hardwaredreams/HD-AK4316/documents/I2C-ADDR-TRANS-1.png

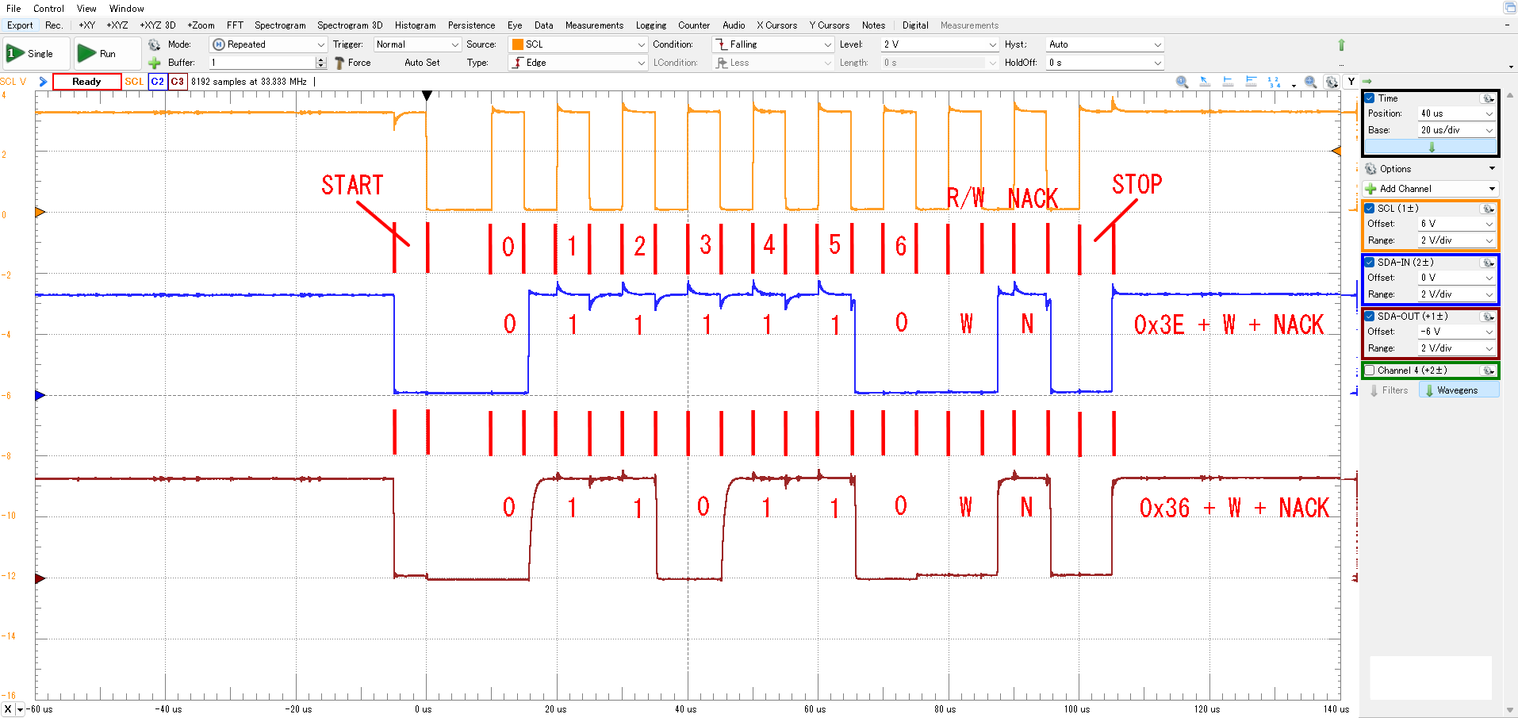
documents/I2C-ADDR-TRANS-1.png
