hardwaredreams/HD-AK4316/documents/I2C-ADDR-TRANS-1s.png

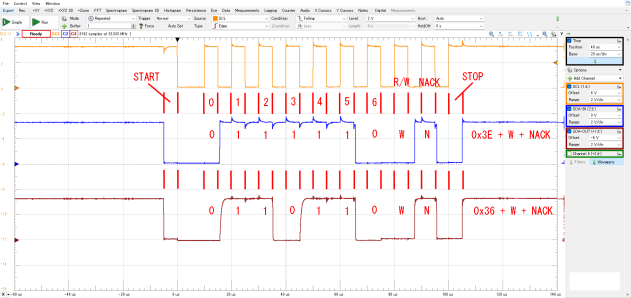
documents/I2C-ADDR-TRANS-1s.png
