hardwaredreams/HD-AK4316/documents/i2c-bus1.png

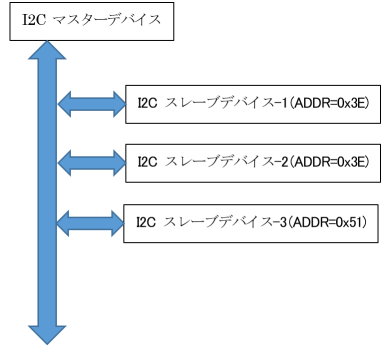
documents/i2c-bus1.png
