hardwaredreams/HD-AK4316/documents/i2c-bus2.png

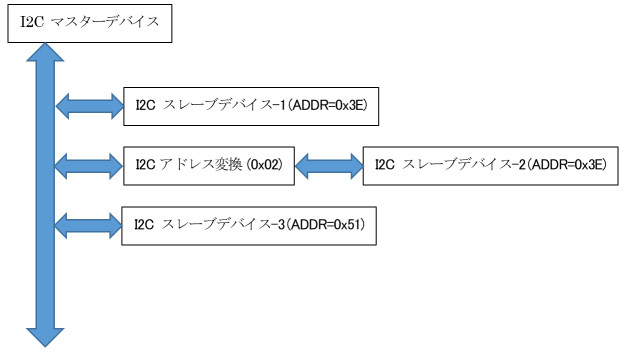
documents/i2c-bus2.png
