hardwaredreams/HD-AK4316/documents/bomlist.xlsx

 |  |  |  |  |  |  | SMT版 完成品 |  | 基板のみ
No. | リファレンス | 数量 | SMT版 | リード版 | 品名 | 仕様 | SMT版 型番 (参考) | メーカー | リード版 型番 (参考) | メーカー | 販売店 (参考) | 秋月電子販売コード | 備考
1 | C1 | 1 | 1 | 0 | セラミックコンデンサ | 1uF/10V以上 | CL10A105KA8NNNC | Samsung Electro-Mechanics |  |  | 秋月電子、Digikey ほか |  | 相当品可
2 | C2 | 1 | 1 | 0 | セラミックコンデンサ | 470pF/10V以上 | C0603C471J5GAC7867 | KEMET |  |  | 秋月電子、Digikey ほか |  | 相当品可
3 | C3 | 1 | 1 | 0 | セラミックコンデンサ | 2.2uF/10V以上 | GRM188R61E225KA12J | Murata Electronics |  |  | 秋月電子、Digikey ほか |  | 相当品可
4 | C4 | 1 | 0 | 1 | セラミックコンデンサ | 1uF/10V以上 |  |  | RDER71H105K2K1H03B | 株式会社村田製作所 | 秋月電子、Digikey ほか | 108150 | 相当品可
5 | C5 | 1 | 0 | 1 | セラミックコンデンサ | 2.2uF/10V以上 |  |  | RDER71H225K2K1H03B | 株式会社村田製作所 | 秋月電子、Digikey ほか | 108152 | 相当品可
6 | CN1, CN2 | 2 | 2 | 2 | Grove コネクタ(互換品) | HY-2 | 114020162/114020164 | Seeed Studio(シードスタジオ) | 114020162/114020164 | Seeed Studio(シードスタジオ) | 秋月電子、スイッチサイエンスほか | 115514 | 相当品可
7 | R1, R2, R3 | 3 | 3 | 2 | 抵抗 | 10k/0.25W | RC0603FR-0710KL | YAGEO | RD25S 10K | SHIH HAO Electronics CO.,LTD | 秋月電子 ほか | 125103 | 相当品可
8 | R4 | 1 | 0 | 0 | 抵抗 | OPEN (未実装) |  |  |  |  |  |  | 設定値により変更 1%級以上 相当品可
9 | R5 | 1 | 1 | 1 | 抵抗 | 0 (ジャンパ抵抗) | ERJ-3GEY0R00V | Panasonic | RD25S 0E | SHIH HAO Electronics CO.,LTD | 秋月電子 ほか | 125000 | 設定値により変更 1%級以上 相当品可
10 | R6 | 1 | 1 | 1 | 抵抗 | 887k/1%/0.25W | ERJ-3EKF8873V | Panasonic | MFR-25FTE52-887K | YAGEO | Digikey, マルツ ほか |  | 設定値により変更 1%級以上 相当品可
11 | R7 | 1 | 1 | 1 | 抵抗 | 1000k/1%/0.25W | ERJ-3EKF1004V | Panasonic | MFR-25FTE52-1M | YAGEO | Digikey, マルツ ほか |  | 設定値により変更 1%級以上 相当品可
12 | U1 | 1 | 1 | 1 | I2Cアドレス変換基板 | AE-LTC4316 | AE-LTC4316 | 秋月電子 | AE-LTC4316 | 秋月電子 | 秋月電子 | 115789
13 | U2 | 1 | 1 | 0 | LDO 電源IC | TPS74033FS5 | TPS74033SF5 | TAEJIN TECHNOLOGY |  |  | 秋月電子 | 117230 | 相当品可 (パッケージ等に注意)
14 | U3 | 1 | 0 | 1 | LDO 電源IC | LP2950L-33-T92-K |  |  | LP2950L-33-T92-K | UNISONIC TECHNOLOGIES | 秋月電子 | 108749 | 相当品可 (パッケージ等に注意)
