hardwaredreams/HD-AK4316/documents/HD-AK4316_schematic.pdf

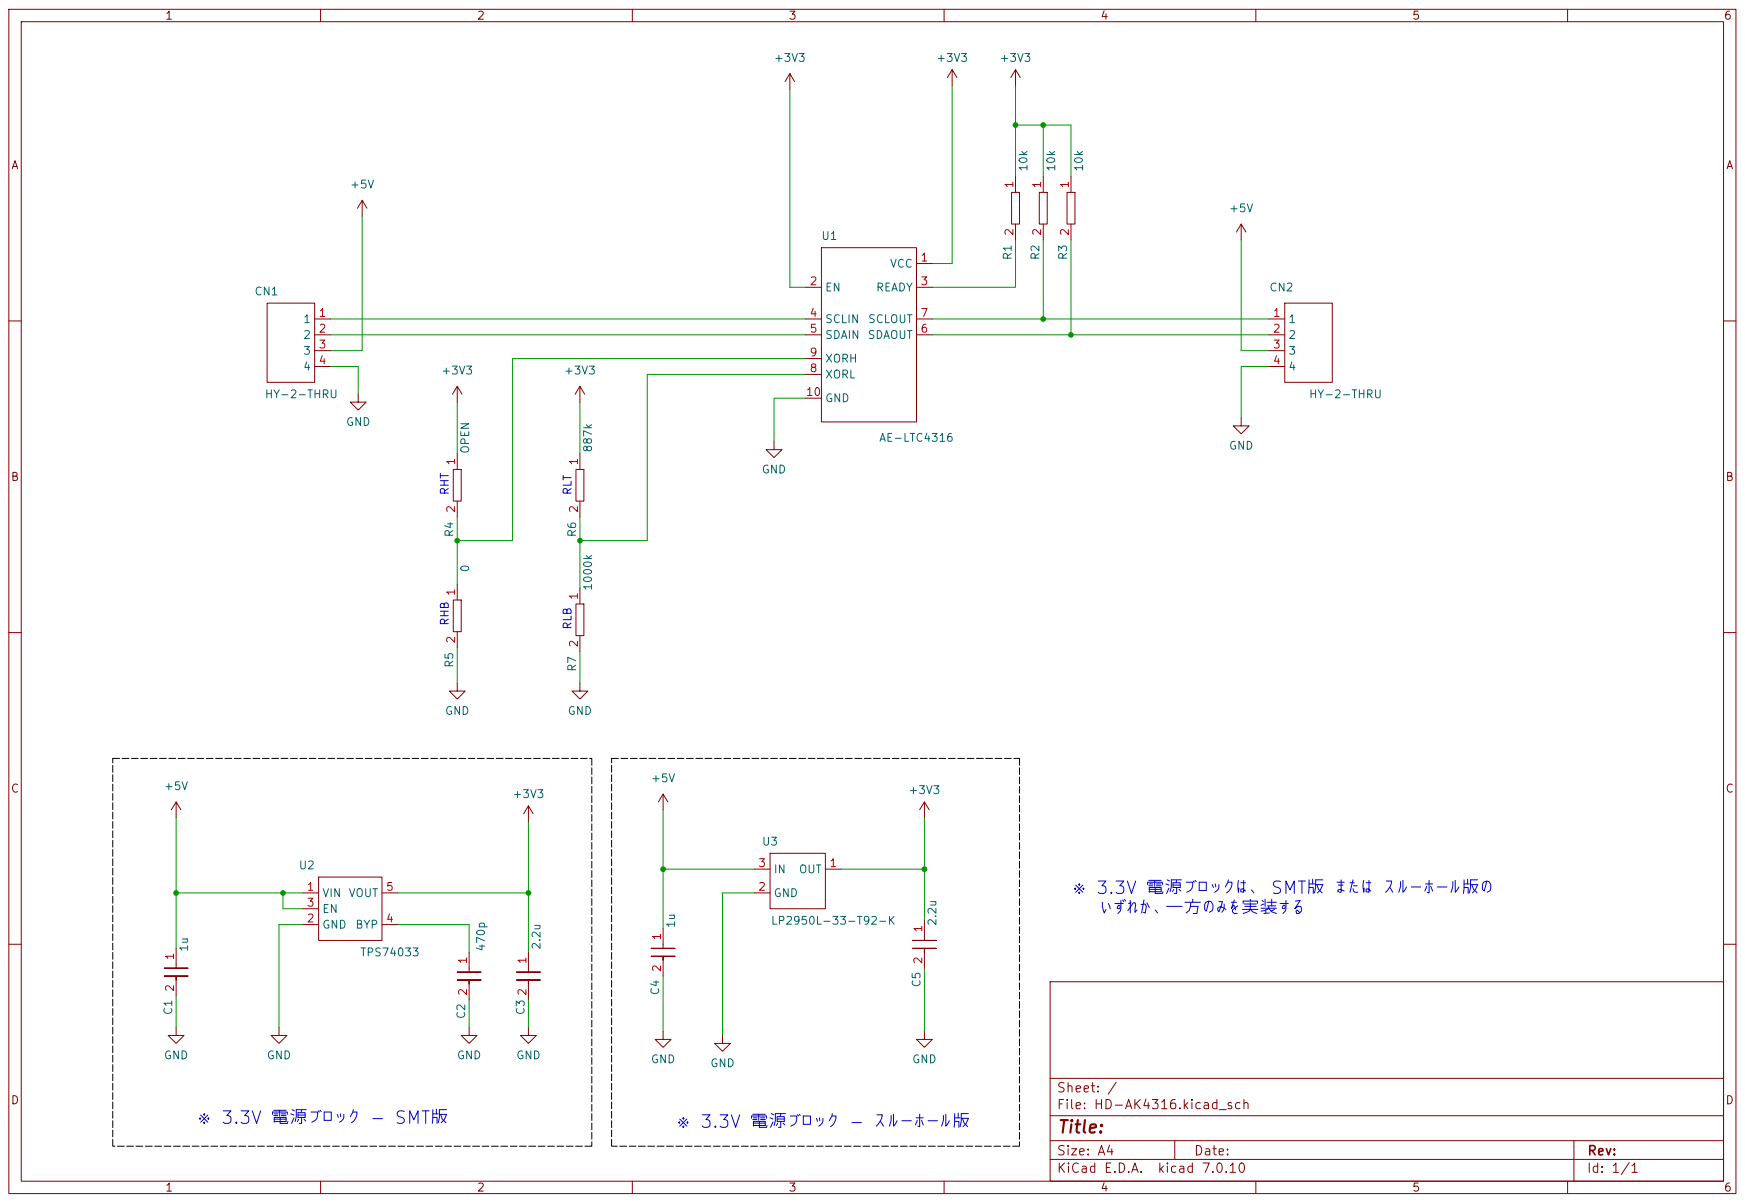
[picture p5: page 1]
