hardwaredreams/HD-AK4316/(commit log)

2024-04-13 1st commit
    [HD-AK4316-B_Cu.gbr, HD-AK4316-B_Mask.gbr, HD-AK4316-B_Paste.gbr, HD-AK4316-B_Silkscreen.gbr, HD-AK4316-Edge_Cuts.gbr, HD-AK4316-F_Cu.gbr, HD-AK4316-F_Mask.gbr, HD-AK4316-F_Paste.gbr]
2024-04-13 add gerber.zip file
2024-04-13 remove old files
    [HD-AK4316-B_Cu.gbr, HD-AK4316-B_Mask.gbr, HD-AK4316-B_Paste.gbr, HD-AK4316-B_Silkscreen.gbr, HD-AK4316-Edge_Cuts.gbr, HD-AK4316-F_Cu.gbr, HD-AK4316-F_Mask.gbr, HD-AK4316-F_Paste.gbr]
2024-04-13 remove old version
    [HD-AK4316.kicad_pcb, HD-AK4316.kicad_sch]
2024-04-17 add files, gerber and drill
    [HD-AK4316-B_Cu.gbr, HD-AK4316-B_Mask.gbr, HD-AK4316-B_Paste.gbr, HD-AK4316-B_Silkscreen.gbr, HD-AK4316-Edge_Cuts.gbr, HD-AK4316-F_Cu.gbr, HD-AK4316-F_Mask.gbr, HD-AK4316-F_Paste.gbr]
2024-04-17 add files, kicad files and bomlist
    [HD-AK4316.kicad_pcb, HD-AK4316.kicad_sch, bomlist.xlsx]
2024-04-24 update: U2: partsnumber
    [HD-AK4316.kicad_sch]
